Horton619/TallyWatch/(commit log)

2026-07-21 feat: initial TallyWatch build — VEP-branded modernization pass
    Rewrites the DIYTallyLight.ino prototype into TallyWatch: custom
    VEP dark-themed setup page (replacing WiFiManager's default portal),
    saved WiFi networks with static IP, JSON config import/export, and
    per-indicator LED toggles. Companion Satellite protocol and LED
    status logic carried over unchanged.
2026-07-22 feat: VEP UI redesign + full deployment tooling & docs
    Modernize the setup page to VEP dark styling (cyan accent, state-aware
    menu rows, SVG icons, hero animation) and build out the deployment path:
    - web: state-aware Network/Companion status, attention-cascade save
    button, two-step exit, monoline icons, reduced-motion hero
    - firmware: LED_PIN -> GPIO3 (off C3 strapping pins) for the real
    Super Mini + WS2812B build; documented the 3V3 data-level fix
    - tools: flash.sh + setup-toolchain.sh for no-IDE batch flashing
    - docs: BUILD.md assembly/deploy guide, basestation-maplite.md
    (mAP lite NAT config for static/no-DHCP production networks),
    V2_BATTERY.md parked variant + shopping list
    C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
    [TallyWatch.ino]
2026-07-22 fix: firmware compiles clean for ESP32-C3
    Verified with arduino-cli against esp32:esp32:esp32c3.
    - rename webserver.h -> web_routes.h: on a case-insensitive filesystem
    (macOS) a local webserver.h shadows the ESP32 core's <WebServer.h>,
    so the include resolved to the wrong file and double-included
    - drop invalid ArduinoJson `(doc[x] | default).as<String>()` chaining;
    the `| default` already yields the field type
    - add .gitignore for .build/ and .DS_Store
    [TallyWatch.ino, web_routes.h]
2026-07-22 feat: WiFi OTA updates + TallyWatch Manager + release CI
    Beacons are now discoverable and updatable over WiFi, with a desktop
    app to manage a fleet — designed around always-isolated show networks
    (the manager is the courier: pull from GitHub online, push to beacons
    offline).
    Firmware:
    - run web server + mDNS (_tallywatch._tcp) during normal operation
    - /update/firmware (self-flash via Update.h), /status, /setlabel,
    /identify endpoints; friendly device label persisted
    - identify LED blink; compiles clean at 82% flash
    Setup page:
    - Firmware section with .bin upload (real XHR progress bar) + Device Name
    Manager (manager/, Electron):
    - mDNS discovery, live status dashboard (VEP dark/cyan)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
2026-07-22 feat: bundle firmware into manager for zero-click update awareness
    The manager now ships with a known-good firmware baked in (the floor),
    so on launch it flags out-of-date beacons with no clicks — a fleet
    summary + one-click "Update all", per-beacon "Latest" / "Update -> vX".
    GitHub is the ceiling: a background check prefers a newer release when
    the laptop is online.
    - manager/firmware/: bundled bin (git-ignored) + manifest (committed)
    - manager/tools/bundle-firmware.sh: compiles + bakes the bin in
    - main.js: bundled vs github firmware resolution (activeFirmware)
    - renderer: auto baseline on launch, fleet bar, state-aware buttons
    - ignore build/ artifacts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
2026-07-22 feat: foolproof beacon IP editor (adapter picker + validation)
    The manager now derives subnet/gateway from a selected network adapter,
    so the user only types an IP — never a mask, gateway, or DNS.
    - network segment in the UI: adapter dropdown showing the computer's IP/subnet
    - IP modal reduced to a single IP field; subnet + gateway auto-derived
    - hard block on invalid IPv4; warn-and-choose (Fix / Continue) popup when
    the IP is on the wrong subnet or answers a ping (likely in use)
    - main: sys:adapters (with netmask) + net:ipInUse (system ping)
    [main.js]
2026-07-23 fix: promote beacon IP editing to a visible Network button
    The IP editor was a subtle grey "network" link by the beacon name and
    was easy to miss; it's now a labeled Network button in the actions row.
2026-07-23 feat: inline rename, Change IP button, off-subnet alerts, manual rescan
    Manager UX pass from live feedback:
    - beacon name is an inline-editable field with a Save button on change
    (dropped the separate rename modal/link)
    - "Network" button renamed to "Change IP"
    - off-subnet beacons get loud treatment: sorted to top, red card + badge,
    accented Change IP, and a red banner listing them
    - dropped the 3s status poll; status refreshes once when a beacon first
    appears and on the Rescan button (safer, no mid-edit re-render churn)
2026-07-23 fix: clicking beacon name no longer opens the Change IP modal
    The name input and Change IP button both carried data-ip, so the
    [data-ip] click handler fired openIp() on the name field too. Moved the
    button to data-changeip; the name input keeps data-ip for identification only.
2026-07-24 docs: beacon schematic + wiring guide; correct LED supply guidance
    Adds docs/wiring.md with the full schematic, power budget, and bench
    troubleshooting, and corrects earlier advice:
    - LED VCC now comes from 5V through a SILICON diode (1N4148/1N4007,
    ~0.7V drop -> ~4.3V), not from the 3V3 pin and not via a Schottky.
    3.3V sits below the WS2812B's ~3.5V minimum, so green/blue wash out
    and colors skew red -- unacceptable on a tally light. A Schottky's
    ~0.3V drop leaves no logic margin.
    - Confirms USB alone powers board + LED (~150-200 mA vs 500 mA+); no
    external supply or power splitting needed.
    [TallyWatch.ino]
2026-07-24 docs: add beginner soldering guide
    Companion to docs/wiring.md for someone with zero electronics
    experience: safety, a shopping list, iron setup, the heat-the-parts-not-
    the-solder technique, good vs cold joint identification, a practice
    routine, the three beacon joints (incl. the heat-sensitive WS2812B and
    the diode splice), and how to fix mistakes.
2026-07-24 docs: define soldering jargon (tin, flux, wetting)
    The guide used "tin" as a verb throughout without defining it, which
    reads like a material to purchase. Adds a glossary up front and
    clarifies that rosin-core solder already carries its own flux; lists a
    flux pen as optional (mainly for desoldering rework).
2026-07-25 feat: manager Configure button + first hardware validation
    First beacon works end-to-end on real hardware: ESP32-C3 + WS2812B (via
    series diode, USB-C powered), flashed, on WiFi, registered with Companion
    as a Satellite surface, mirroring a button's color.
    - manager: "Configure" button opens a beacon's live setup page
    (http://<ip>/) via shell.openExternal — no BOOT-into-setup-mode needed
    once a beacon is on the network
    - docs: record the hardware milestone; README limitation updated to
    "validated end-to-end on hardware"
2026-09-11 feat: brand manager as Lightkeeper + Windows installer pipeline
    The management app becomes "Lightkeeper" — the guiding light that tends
    the fleet of TallyWatch beacons — with an emerald-lighthouse icon.
    - rename: productName/appId/window title/README/UI header -> Lightkeeper
    - add build/icon.svg + icon.png (emerald lighthouse); electron-builder
    generates the Windows .ico
    - add .github/workflows/release-manager.yml: NSIS installer built on a
    manager-v* tag, attached to a Release for double-click install
    - anchor the build/ gitignore rule to repo root so manager/build/ commits
2026-09-11 feat: bake zero-touch provisioning defaults via git-ignored secrets.h
    A fresh beacon flashed locally now auto-joins WiFi and points at Companion
    on first boot, skipping the setup page. Values live in secrets.h (ignored,
    stays off GitHub); without it (CI/release build) defaults are blank and the
    beacon boots to setup mode. NVS settings always override these.
    [TallyWatch.ino, secrets.example.h]
2026-09-11 feat: USB serial provisioning in Lightkeeper
    Configure beacons over their USB cable before they're ever on WiFi,
    solving the chicken-and-egg where a network-only manager can't reach an
    unconfigured beacon.
    Firmware: a line-delimited JSON command protocol over the native USB-CDC
    port (ping/getconfig/getabout/save/locate/reboot), pumped from every loop
    (normal, WiFi-connect, setup mode) so it answers regardless of network
    state. connectWiFi() no longer reboots when no saved network is reachable
    -- that dropped the USB port every ~24s and made bench provisioning
    impossible. A locate command holds the pixel solid red for hover-identify.
    Shared config/about JSON builders in web_routes.h keep ser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
    [TallyWatch.ino, main.js, web_routes.h]
2026-09-11 fix: build release firmware with CDCOnBoot=cdc
    The release CI and bundle-firmware.sh compiled with the plain esp32c3
    FQBN, but CDCOnBoot=cdc is a compile-time flag that routes Serial to the
    native USB port. Without it, a released/OTA'd binary can't speak the USB
    serial provisioning protocol at all. Match flash.sh so every build path
    produces USB-provisioning-capable firmware.
2026-09-12 fix: derive beacon id from eFuse MAC so a fleet isn't all one id
    macSerial() read WiFi.macAddress() from setup(), before any WiFi init.
    arduino-esp32 core v3 removed the esp_read_mac fallback core v2 had, so
    that returns 00:00:00:00:00:00 when the WiFi driver isn't up. Every
    beacon then persisted the same id (TallyWatch:000000000000), and since
    Companion routes Satellite surfaces by DEVICEID/SERIAL, only one beacon
    was ever visible at a time. A lone beacon had nothing to collide with,
    so the first hardware bring-up didn't surface it.
    Read the MAC straight from eFuse via esp_read_mac(), which works with
    WiFi down. Beacons that already stored the all-zero id regenerate a real
    one on next boot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
    [TallyWatch.ino, web_routes.h]
2026-09-12 fix: heal any zero-OUI beacon id, not just the exact all-zero string
    The self-heal added in the previous commit only matched the literal
    "TallyWatch:000000000000". On real hardware the broken pre-WiFi
    WiFi.macAddress() read yields other zero-OUI garbage too (e.g.
    000000xxxxxx), which is still duplicated across a fleet but was slipping
    past the exact-string check, so those units would not have healed on
    reflash. Match the zero-OUI fingerprint (first three bytes 00:00:00),
    which a real NIC never has, so every affected beacon regenerates a real
    eFuse-derived id on the next boot.
    Claude-Session: https://claude.ai/code/session_01RwiWyvRHTnC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
    [TallyWatch.ino]
2026-09-12 fix: keep USB serial provisioning responsive during WiFi churn
    Layer the provisioning-reliability fixes validated on hardware onto the
    eFuse device-id fix. Symptom was USB "save" timing out (and scans/hover
    lagging) whenever a bench beacon couldn't reach its show network:
    - Radio-off provisioning mode: while the host is actively talking over USB
    (any inbound byte within 30s), stop WiFi/Companion connect attempts and
    turn the radio off. Those blocking connects starve the single-core loop
    for seconds, and NVS writes stall while the radio is up -- both broke the
    serial session. Normal operation resumes once the host goes quiet.
    - Ack a save before persisting to NVS, so a flash-write st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
    [TallyWatch.ino]
